EridaniBrew/BrewFocuser/Doc/MoonlightDoc/IMG_0924.JPG

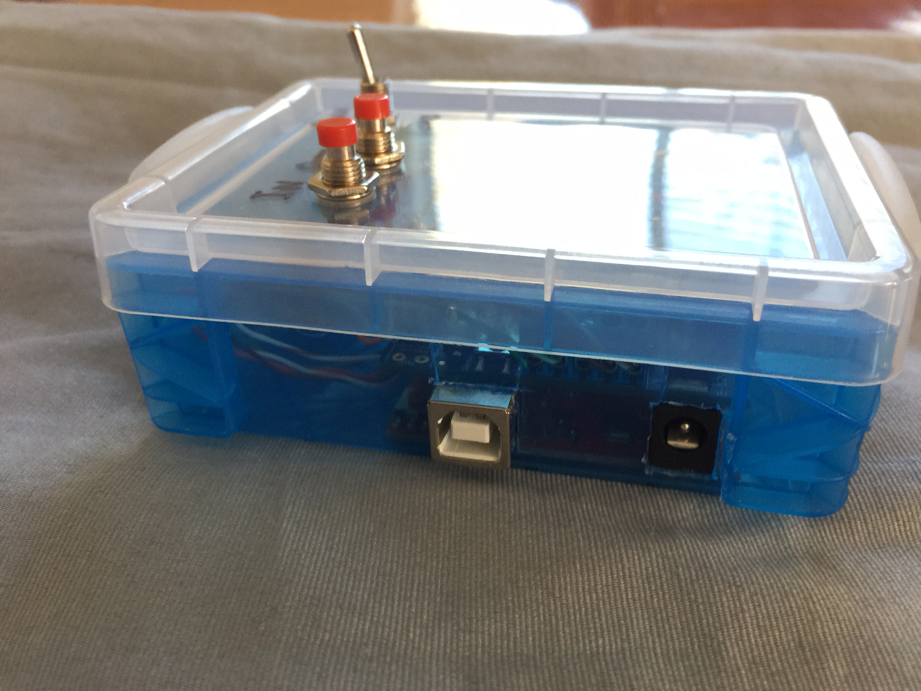
Doc/MoonlightDoc/IMG_0924.JPG
