EridaniBrew/BrewFocuser/Doc/IMG_0984.JPG

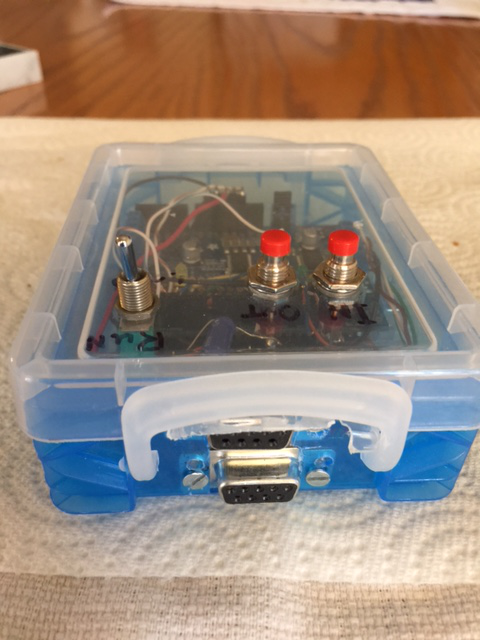
Doc/IMG_0984.JPG
