EridaniBrew/BrewFocuser/Doc/IMG_0975.JPG

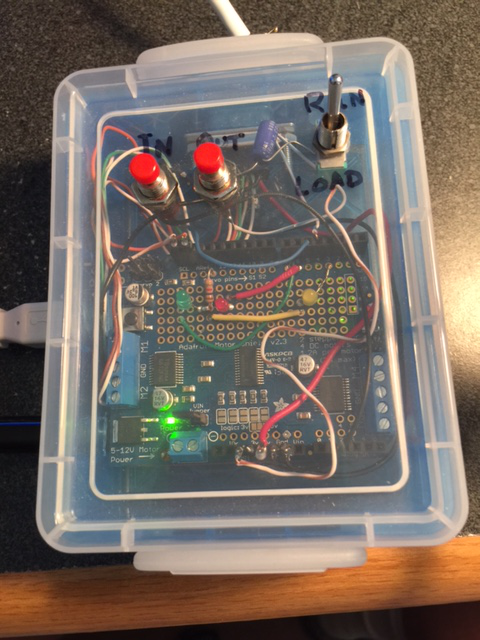
Doc/IMG_0975.JPG
