EridaniBrew/BrewFocuser/Doc/IMG_0976.JPG

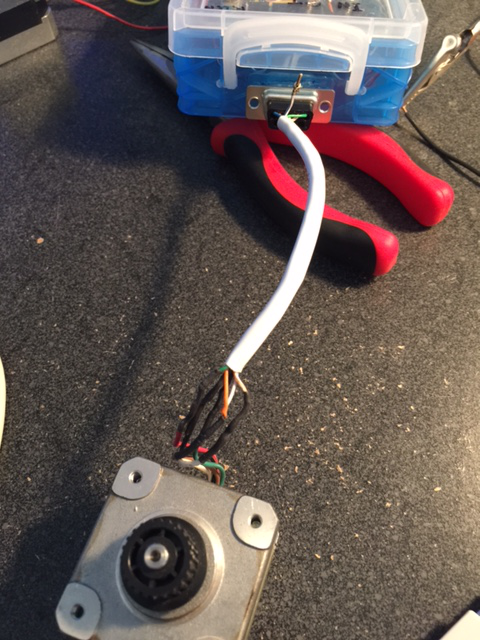
Doc/IMG_0976.JPG
