EridaniBrew/BrewFocuser/Doc/IMG_0977.JPG

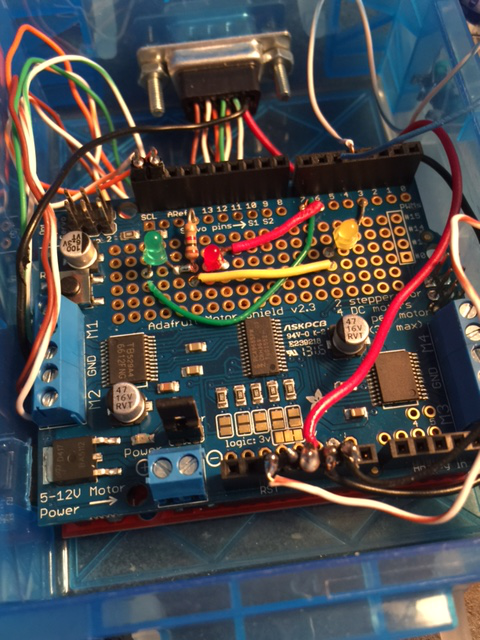
Doc/IMG_0977.JPG
