EridaniBrew/BrewFocuser/Doc/IMG_0978.JPG

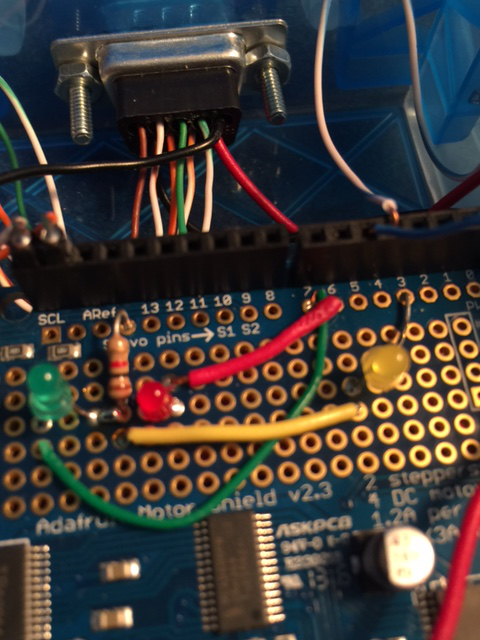
Doc/IMG_0978.JPG
