EridaniBrew/BrewFocuser/Doc/IMG_0979.JPG

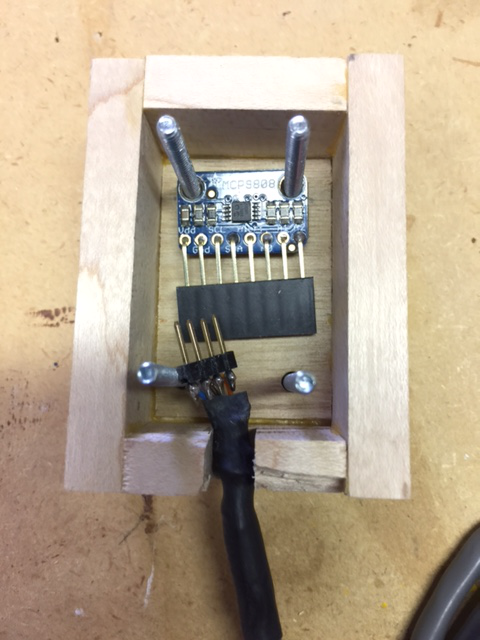
Doc/IMG_0979.JPG
