EridaniBrew/BrewFocuser/Doc/IMG_0980.JPG

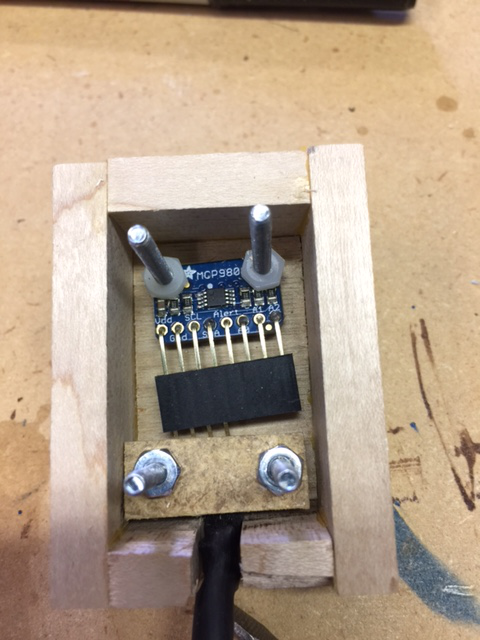
Doc/IMG_0980.JPG
