EridaniBrew/BrewFocuser/Doc/IMG_0982.JPG

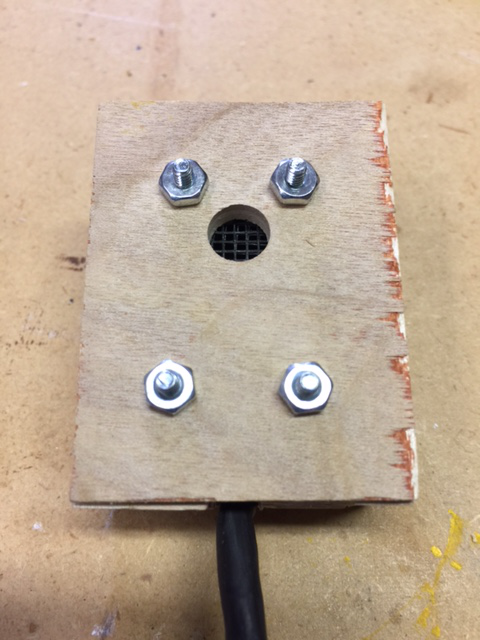
Doc/IMG_0982.JPG
