EridaniBrew/BrewFocuser/Doc/IMG_0983.JPG

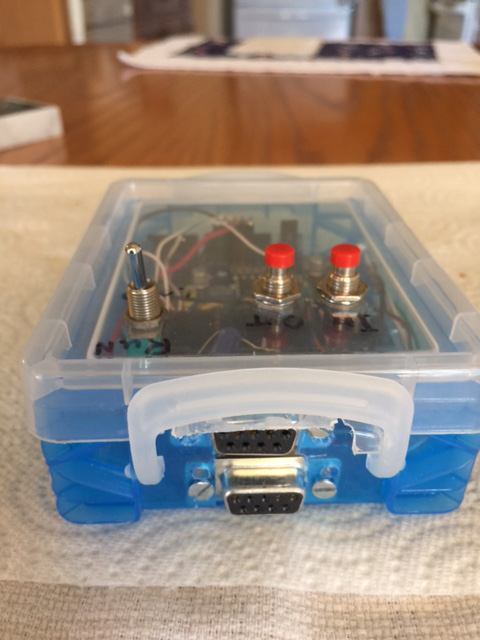
Doc/IMG_0983.JPG
