EridaniBrew/BrewFocuser/Doc/IMG_0985.JPG

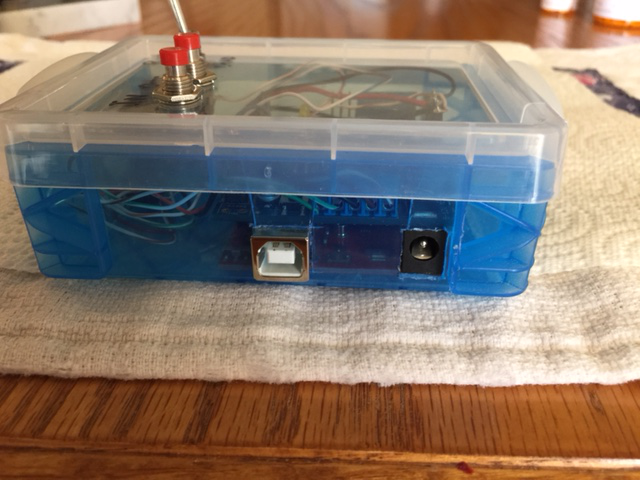
Doc/IMG_0985.JPG
