EridaniBrew/BrewFocuser/Doc/IMG_0986.JPG

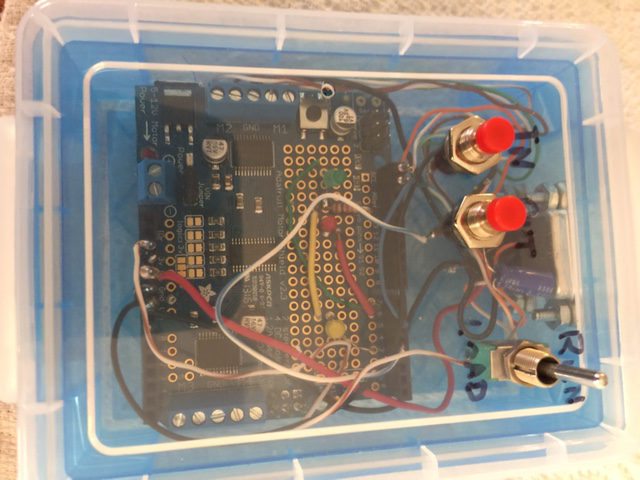
Doc/IMG_0986.JPG
