EridaniBrew/BrewFocuser/Doc/MoonlightDoc/BoxFront20.jpg

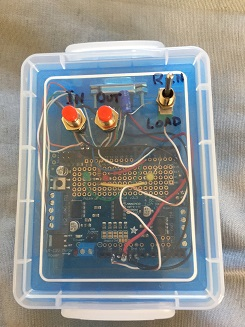
Doc/MoonlightDoc/BoxFront20.jpg
