EridaniBrew/BrewFocuser/Doc/MoonlightDoc/IMG_0925.JPG

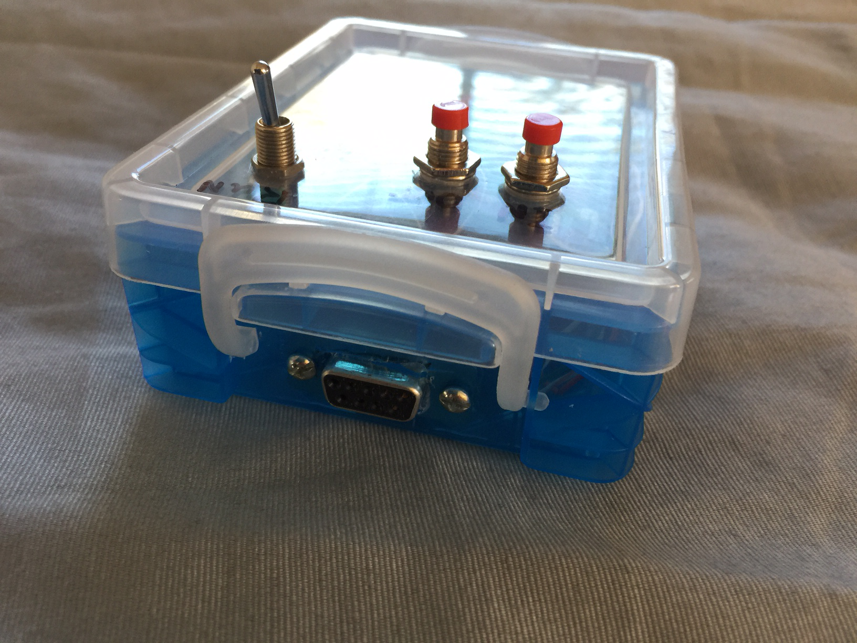
Doc/MoonlightDoc/IMG_0925.JPG
