EridaniBrew/BrewFocuser/Doc/MoonlightDoc/IMG_0926.JPG

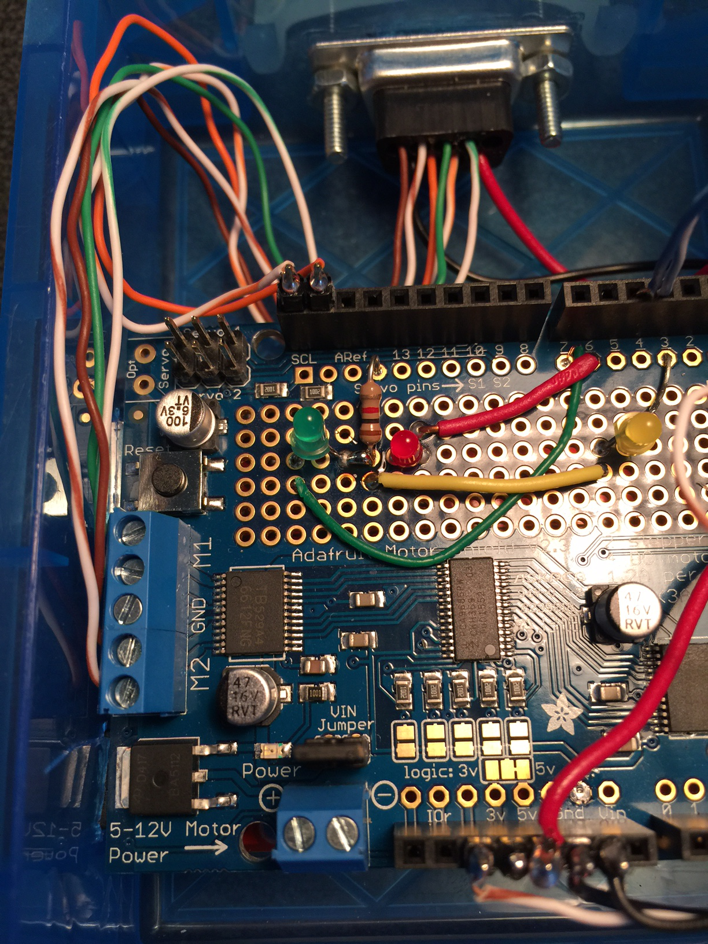
Doc/MoonlightDoc/IMG_0926.JPG
