EridaniBrew/BrewFocuser/Doc/MoonlightDoc/IMG_0927.JPG

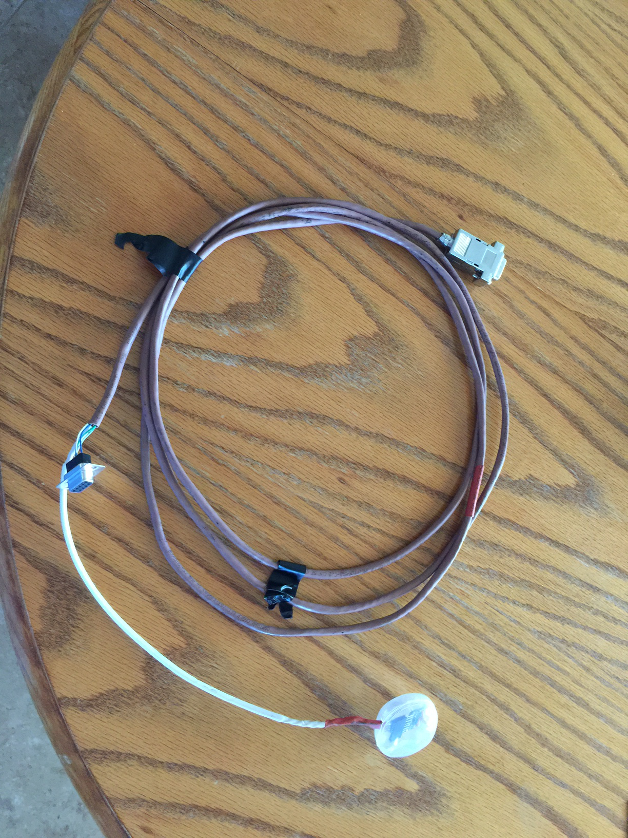
Doc/MoonlightDoc/IMG_0927.JPG
