EridaniBrew/BrewFocuser/Doc/BrewFocuserWiring_bb.png

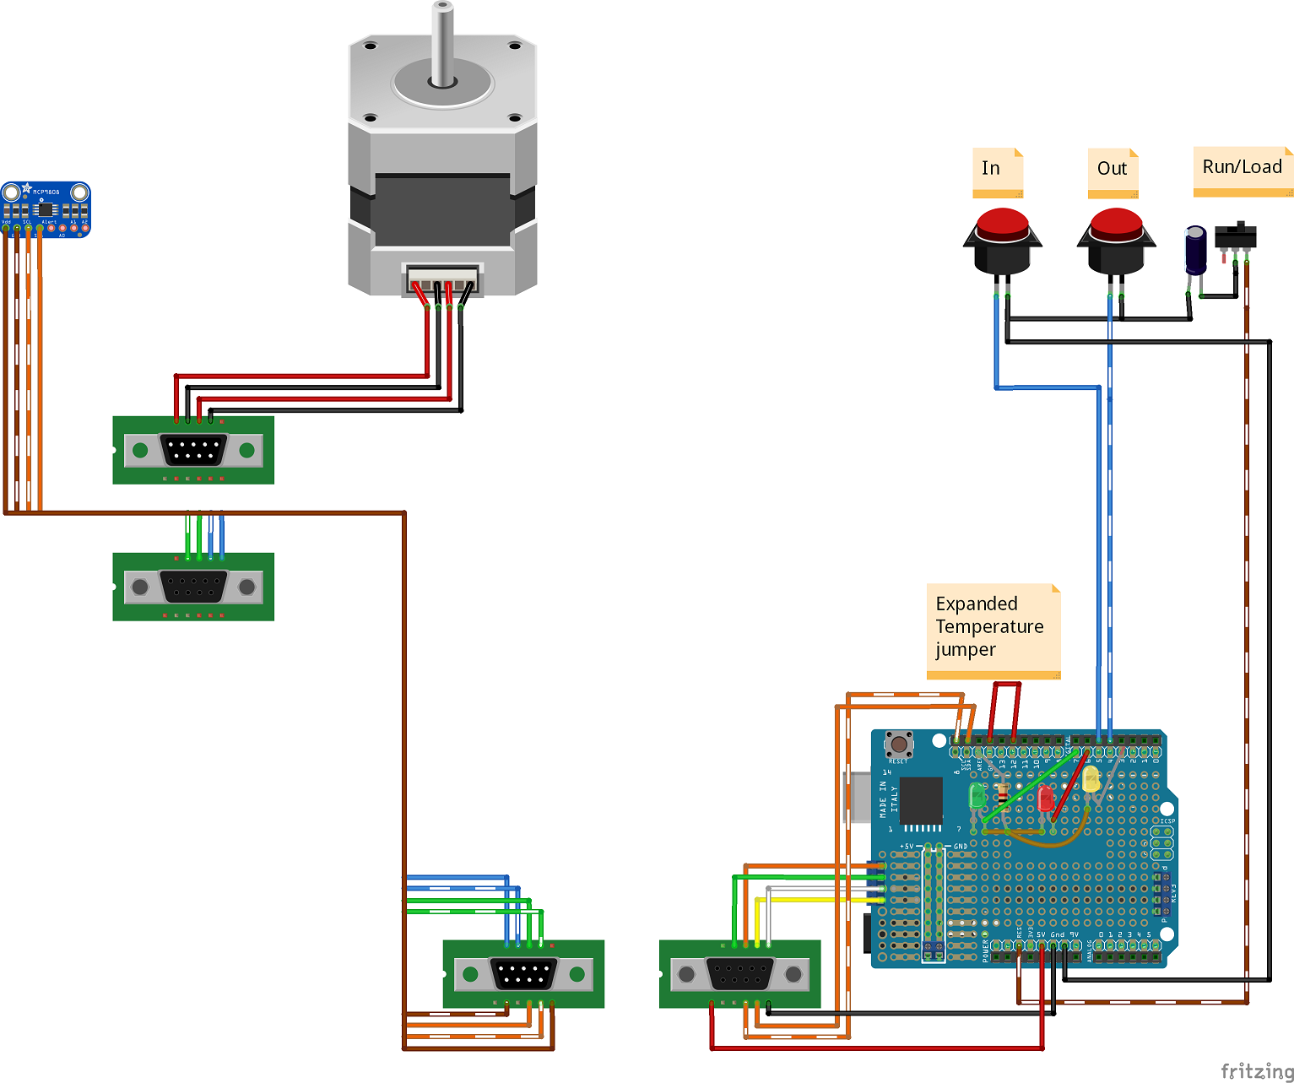
Doc/BrewFocuserWiring_bb.png
