EridaniBrew/BrewFocuser/(list of files, drawings)

Other design files:
Doc/BrewFocuserWiring.fzz
